adafruit/BLM-Badge-PCB/README.md

# BLM-Badge-PCB

Black Lives Matter interactive electronic learning kit.

https://www.adafruit.com/blacklivesmatter

CAD files are released under Public Domain

https://creativecommons.org/share-your-work/public-domain/
