adafruit/BLM-Badge-PCB/BLM Badge rev B.brd

## EAGLE design BLM Badge rev B.brd (2020-08-29)

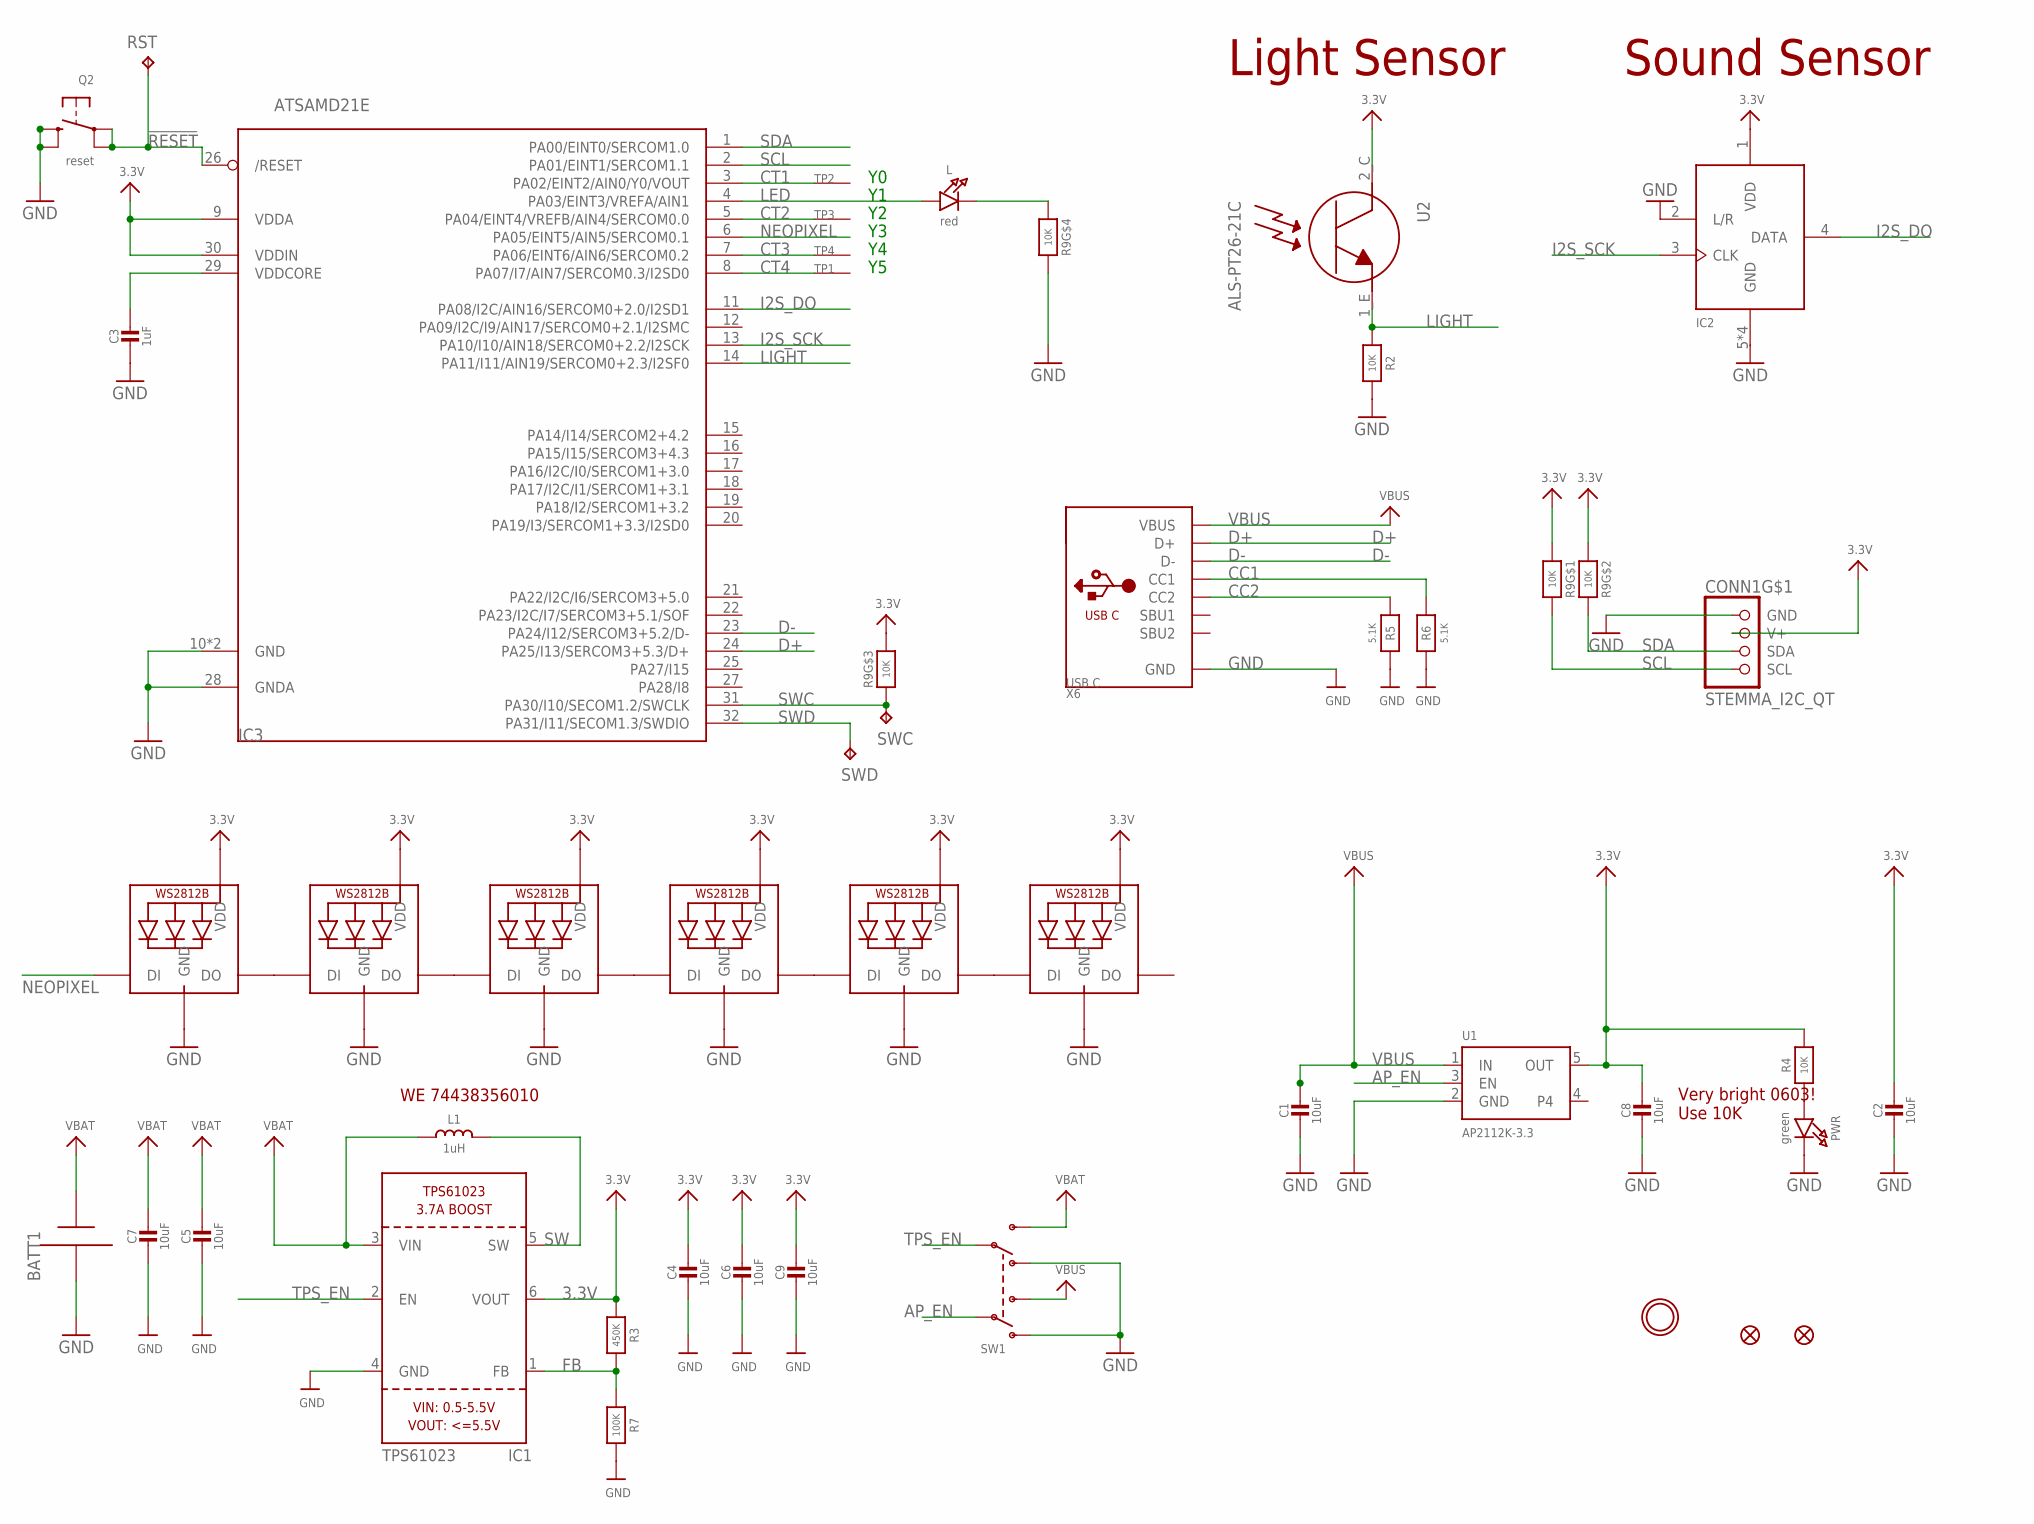
[picture p1: schematic BLM Badge rev B.sch]

Parts:
BATT1: BATTERYHOLDER_2XAAA; 2XAAA
C1, C2, C4, C5, C6, C7, C8, C9: 10uF; 0805-NO
C3: 1uF; 0603-NO
CONN1: STEMMA_I2C_QT; JST_SH4
FID1, FID2: FIDUCIAL_1MM
IC1: TPS61023; SOT563
IC2: MIC_PDM; SPK0415HM4H
IC3: ATSAMD21E; QFN32_5MM
L: red; CHIPLED_0603_NOOUTLINE
L1: 1uH; INDUCTOR_5X5MM_TDK_VLC5045
LED2, LED3, LED4, LED5, LED6, LED7: WS2812B_4020
PWR: green; CHIPLED_0603_NOOUTLINE
Q2: reset; BTN_KMR2_4.6X2.8
R2, R4: 10K; 0603-NO
R3: 450K; 0603-NO
R5, R6: 5.1K; 0603-NO
R7: 100K; 0603-NO
R9: 10K; RESPACK_4X0603
RST: TPTP17R; TP17R
SW1: SWITCH_DPDTEG1390; EG1390
SWC: TPTP17R; TP17R
SWD: TPTP17R; TP17R
TP1, TP2, TP3, TP4: SEWTAPPCB_ALLIGATOR; PCB_ALLI
U1: AP2112K-3.3; SOT23-5
U2: ALS-PT26-21C
U$33: MOUNTINGHOLE3.0THIN; MOUNTINGHOLE_3.0_PLATEDTHIN
X6: USB C; USB_C_CUSB31-CFM2AX-01-X

Connections:
3.3V: C2.1, C4.1, C6.1, C8.1, C9.1, CONN1.2 (V+), IC1.6 (VOUT), IC2.1 (VDD), IC3.9 (VDDA), IC3.30 (VDDIN), LED2.2 (VDD), LED3.2 (VDD), LED4.2 (VDD), LED5.2 (VDD), LED6.2 (VDD), LED7.2 (VDD), R3.1, R4.2, R9.1, R9.2 (1), R9.6 (2), U1.5 (OUT), U2.2_C (C)
!RESET: IC3.26 (/RESET), Q2.A, Q2.A' (P1), RST.TP
AP_EN: SW1.P1, U1.3 (EN)
CC1: R6.2, X6.A5 (CC1)
CC2: R5.2, X6.B5 (CC2)
CT1: IC3.3 (PA02/EINT2/AIN0/Y0/VOUT), TP2.P$1
CT2: IC3.5 (PA04/EINT4/VREFB/AIN4/SERCOM0.0), TP3.P$1
CT3: IC3.7 (PA06/EINT6/AIN6/SERCOM0.2), TP4.P$1
CT4: IC3.8 (PA07/I7/AIN7/SERCOM0.3/I2SD0), TP1.P$1
D+: IC3.24 (PA25/I13/SERCOM3+5.3/D+), X6.A6 (D+), X6.B6 (D+)
D-: IC3.23 (PA24/I12/SERCOM3+5.2/D-), X6.A7 (D-), X6.B7 (D-)
FB: IC1.1 (FB), R3.2, R7.1
GND: BATT1.MINUS (-), C1.2, C2.2, C3.2, C4.2, C5.2, C6.2, C7.2, C8.2, C9.2, CONN1.1 (GND), IC1.4 (GND), IC2.2 (L/R), IC2.5 (GND), IC2.6 (GND), IC2.7 (GND), IC2.8 (GND), IC3.10 (GND), IC3.28 (GNDA), IC3.33 (GND), LED2.4 (GND), LED3.4 (GND), LED4.4 (GND), LED5.4 (GND), LED6.4 (GND), LED7.4 (GND), PWR.C, Q2.B (S), Q2.B' (S1), R2.1, R5.1, R6.1, R7.2, R9.5 (2), SW1.O1, SW1.O2, U1.2 (GND), X6.A1B12 (GND), X6.B1A12 (GND)
I2S_DO: IC2.4 (DATA), IC3.11 (PA08/I2C/AIN16/SERCOM0+2.0/I2SD1)
I2S_SCK: IC2.3 (CLK), IC3.13 (PA10/I10/AIN18/SERCOM0+2.2/I2SCK)
LED: IC3.4 (PA03/EINT3/VREFA/AIN1), L.A
LIGHT: IC3.14 (PA11/I11/AIN19/SERCOM0+2.3/I2SF0), R2.2, U2.1_E (E)
unnamed: L.C, R9.4 (1)
unnamed: PWR.A, R4.1
unnamed: LED2.3 (DO), LED3.1 (DI)
unnamed: LED3.3 (DO), LED4.1 (DI)
unnamed: LED4.3 (DO), LED5.1 (DI)
unnamed: LED6.3 (DO), LED7.1 (DI)
unnamed: LED5.3 (DO), LED6.1 (DI)
NEOPIXEL: IC3.6 (PA05/EINT5/AIN5/SERCOM0.1), LED2.1 (DI)
SCL: CONN1.4 (SCL), IC3.2 (PA01/EINT1/SERCOM1.1), R9.8 (2)
SDA: CONN1.3 (SDA), IC3.1 (PA00/EINT0/SERCOM1.0), R9.7 (2)
SW: IC1.5 (SW), L1.P$2 (2)
SWC: IC3.31 (PA30/I10/SECOM1.2/SWCLK), R9.3 (1), SWC.TP
SWD: IC3.32 (PA31/I11/SECOM1.3/SWDIO), SWD.TP
TPS_EN: IC1.2 (EN), SW1.P2
VBAT: BATT1.PLUS (+), C5.1, C7.1, IC1.3 (VIN), L1.P$1 (1), SW1.S2
VBUS: C1.1, SW1.S1, U1.1 (IN), X6.A4B9 (VBUS), X6.B4A9 (VBUS)
VDDCORE: C3.1, IC3.29 (VDDCORE)

Notes on the sheet:
Very bright 0603! Use 10K
WE 74438356010
Sound Sensor
Light Sensor

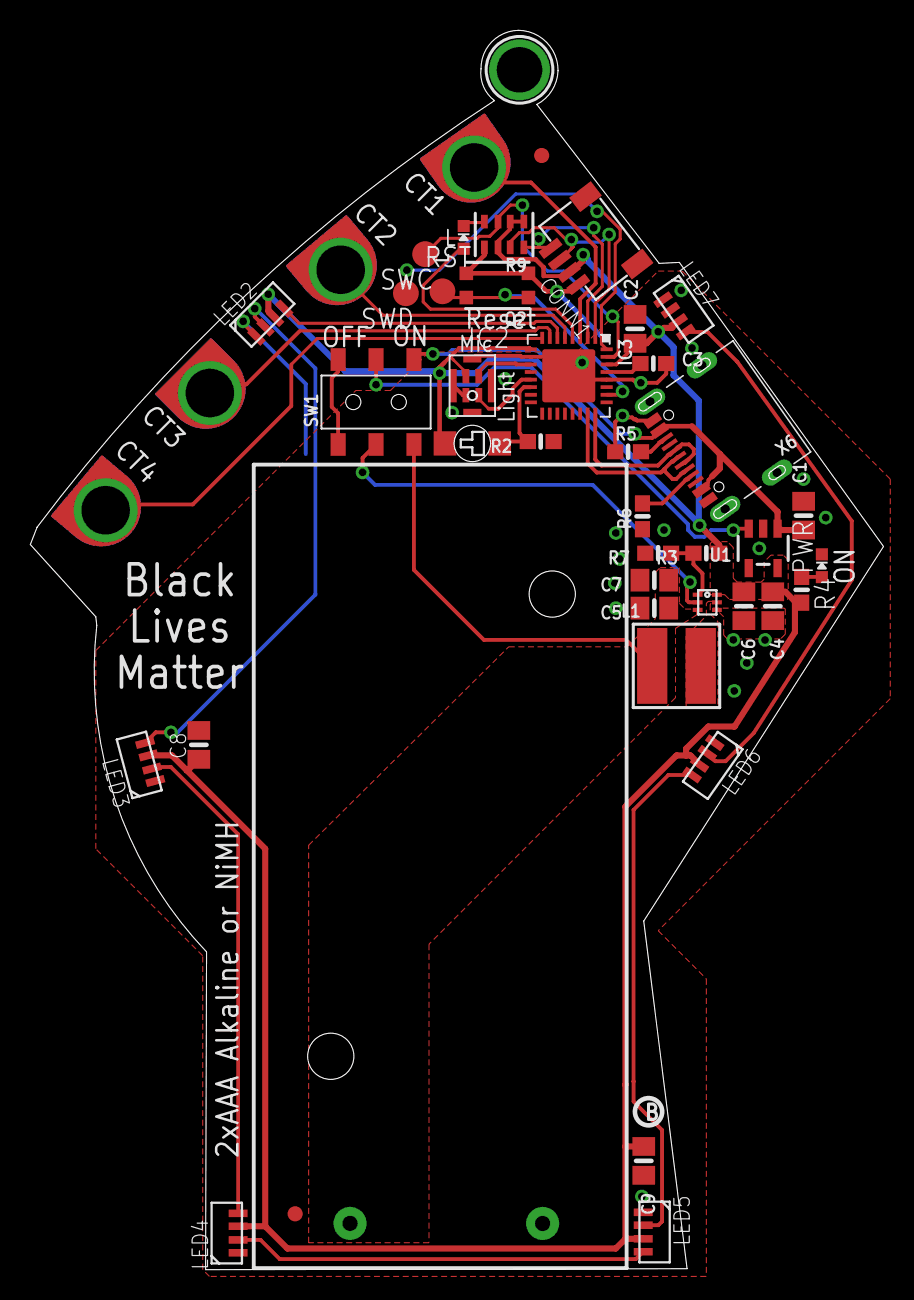
[picture p2: board BLM Badge rev B.brd from above]

Board: 2 copper layers, 56.3 x 81.7 mm, 47 parts (1 on the bottom side), 34 nets.

Other parts of the board:
U$1: BLM_FRONT
U$40: PCBFEAT-REV-040
